dektronics/printalyzer-uvdensitometer/hardware/main-board/main-board.kicad_pcb

## KiCad design hardware/main-board/main-board.kicad_pcb (2025-02-21)

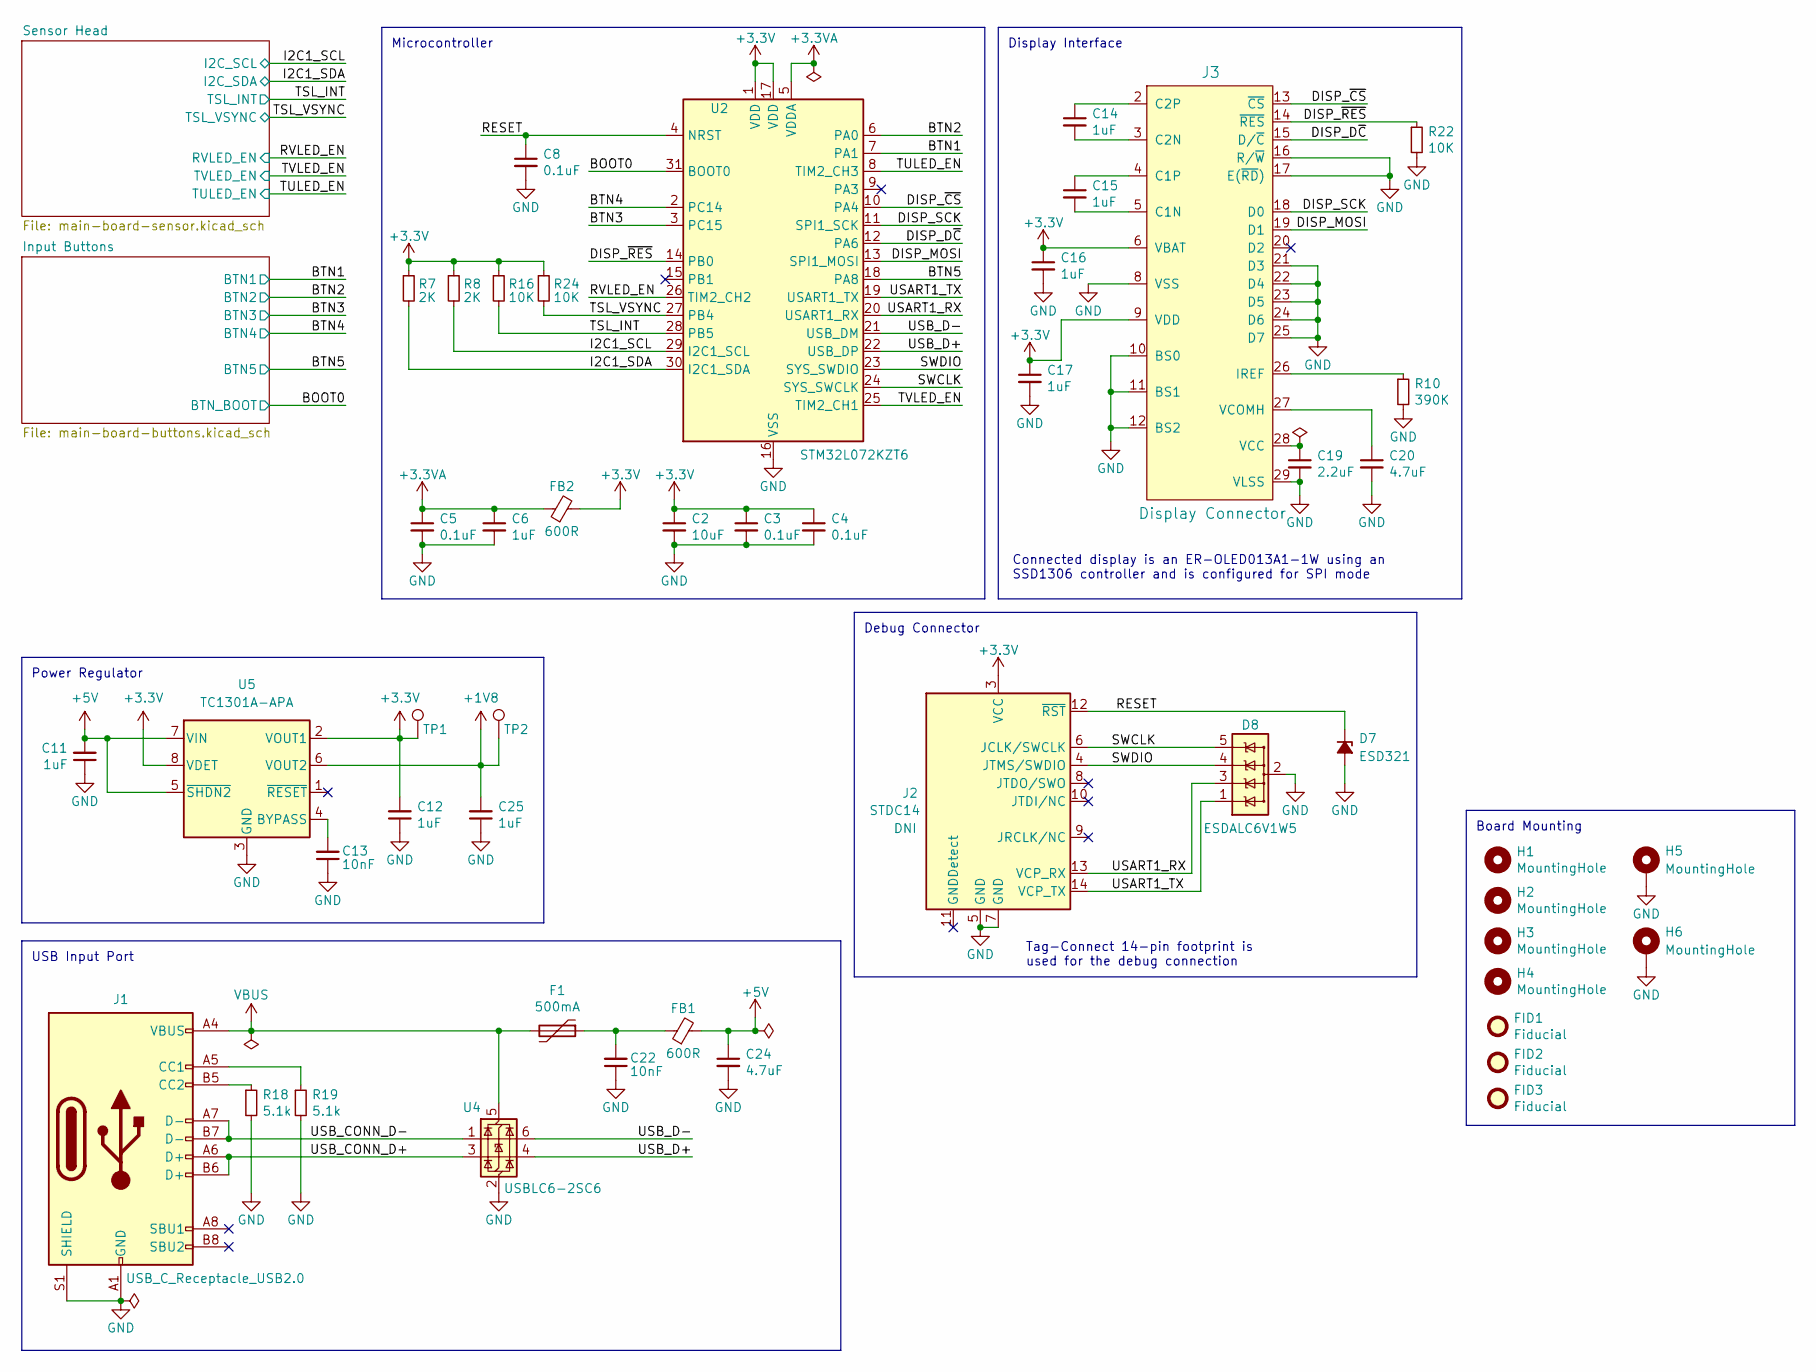
[picture p3: schematic main-board.kicad_sch, Printalyzer UV/VIS Densitometer - Main Board]

Parts:
C2: 10uF; C_0805_2012Metric; Manufacturer PN CL21A106KAYNNNE
C3, C4, C5, C8: 0.1uF; C_0603_1608Metric; Manufacturer PN CL10B104KA8NNNC
C6, C11, C12, C14, C15, C16, C17, C25: 1uF; C_0603_1608Metric; Manufacturer PN CL10B105KA8NNNC
C13, C22: 10nF; C_0603_1608Metric; Manufacturer PN CC0603KRX7R8BB103
C19: 2.2uF; C_0603_1608Metric; Manufacturer PN CL10B225KP8NNNC
C20, C24: 4.7uF; C_0603_1608Metric; Manufacturer PN CL10A475KA8NQNC
D7: ESD321; D_TI_SOD-523_DYA0002A; Manufacturer PN ESD321DYAR
D8: ESDALC6V1W5; SOT323-5L; Manufacturer PN ESDALC6V1W5
F1: 500mA; BF_0ZCJ_1206; Manufacturer PN 1206L050YR
FB1, FB2: 600R; L_0603_1608Metric; Manufacturer PN 742792651
FID1, FID2, FID3: Fiducial; Fiducial_1mm_Mask2mm
H1, H2, H3, H4: MountingHole; MountingHole_2.2mm_M2
H5, H6: MountingHole; MountingHole_2.2mm_M2_Pad_Via
J1: USB_C_Receptacle_USB2.0; USB_C_Receptacle_GCT_USB4105; Manufacturer PN USB4105-GF-A
J2: DNI; Tag-Connect_TC2070-IDC-FP_2x07_P1.27mm_Vertical; Manufacturer PN TC2070-IDC-050
J3: Display Connector; ER-CON30HT-1; Manufacturer PN ER-CON30HT-1
R7, R8: 2K; R_0603_1608Metric; Manufacturer PN CRCW06032K00JNEA
R10: 390K; R_0603_1608Metric; Manufacturer PN RC0603FR-07390KL
R16, R22, R24: 10K; R_0603_1608Metric; Manufacturer PN RC0603JR-0710KL
R18, R19: 5.1k; R_0603_1608Metric; Manufacturer PN RC0603JR-075K1L
TP1: 3.3V; TestPoint_Pad_D1.0mm
TP2: 1.8V; TestPoint_Pad_D1.0mm
U2: STM32L072KZT6; ST_LQFP32; Manufacturer PN STM32L072KZT6
U4: USBLC6-2SC6; SOT-23-6; Manufacturer PN USBLC6-2SC6
U5: TC1301A-APA; MSOP-8_3x3mm_P0.65mm; Manufacturer PN TC1301A-APAVUATR

Connections:
+1V8: C25.2, TP2.1, U5.6 (VOUT2); also elsewhere on the board
+3.3V: C2.1, C3.1, C4.1, C12.2, C16.1, C17.1, FB2.2, J2.3 (VCC), J3.6 (VBAT), J3.9 (VDD), R7.1, R8.1, R16.1, R24.1, TP1.1, U2.1 (VDD), U2.17 (VDD), U5.2 (VOUT1), U5.8 (VDET); also elsewhere on the board
+3.3VA: C5.1, C6.1, FB2.1, U2.5 (VDDA)
+5V: C11.2, C24.1, FB1.2, U5.5 (~SHDN2), U5.7 (VIN); also elsewhere on the board
/BOOT0: U2.31 (BOOT0); also elsewhere on the board
/BTN1: U2.7 (PA1); also elsewhere on the board
/BTN2: U2.6 (PA0); also elsewhere on the board
/BTN3: U2.3 (PC15); also elsewhere on the board
/BTN4: U2.2 (PC14); also elsewhere on the board
/BTN5: U2.18 (PA8); also elsewhere on the board
/DISP_D~C: J3.15 (D/~C), U2.12 (PA6)
/DISP_MOSI: J3.19 (D1), U2.13 (SPI1_MOSI)
/DISP_SCK: J3.18 (D0), U2.11 (SPI1_SCK)
/DISP_~CS: J3.13 (~CS), U2.10 (PA4)
/DISP_~RES: J3.14 (~RES), R22.1, U2.14 (PB0)
/I2C1_SCL: R8.2, U2.29 (I2C1_SCL); also elsewhere on the board
/I2C1_SDA: R7.2, U2.30 (I2C1_SDA); also elsewhere on the board
/RESET: C8.1, D7.2 (K), J2.12 (~RST), U2.4 (NRST)
/RVLED_EN: U2.26 (TIM2_CH2); also elsewhere on the board
/SWCLK: D8.5 (IO4), J2.6 (JCLK/SWCLK), U2.24 (SYS_SWCLK)
/SWDIO: D8.4 (IO3), J2.4 (JTMS/SWDIO), U2.23 (SYS_SWDIO)
/TSL_INT: R16.2, U2.28 (PB5); also elsewhere on the board
/TSL_VSYNC: R24.2, U2.27 (PB4); also elsewhere on the board
/TULED_EN: U2.8 (TIM2_CH3); also elsewhere on the board
/TVLED_EN: U2.25 (TIM2_CH1); also elsewhere on the board
/USART1_RX: D8.3 (IO2), J2.13 (VCP_RX), U2.20 (USART1_RX)
/USART1_TX: D8.1 (IO1), J2.14 (VCP_TX), U2.19 (USART1_TX)
/USB_CONN_D+: J1.A6 (D+), J1.B6 (D+), U4.3 (I/O2)
/USB_CONN_D-: J1.A7 (D-), J1.B7 (D-), U4.1 (I/O1)
/USB_D+: U2.22 (USB_DP), U4.4 (I/O2)
/USB_D-: U2.21 (USB_DM), U4.6 (I/O1)
GND: C2.2, C3.2, C4.2, C5.2, C6.2, C8.2, C11.1, C12.1, C13.1, C16.2, C17.2, C19.2, C20.2, C22.1, C24.2, C25.1, D7.1 (A), D8.2 (GND), H5.1, H6.1, J1.A1 (GND), J1.A12 (GND), J1.B1 (GND), J1.B12 (GND), J1.S1 (SHIELD), J2.5 (GND), J2.7 (GND), J3.8 (VSS), J3.10 (BS0), J3.11 (BS1), J3.12 (BS2), J3.16 (R/~W), J3.17 (E(~RD)), J3.21 (D3), J3.22 (D4), J3.23 (D5), J3.24 (D6), J3.25 (D7), J3.29 (VLSS), R10.2, R18.2, R19.2, R22.2, U2.16 (VSS), U2.32 (VSS), U4.2 (GND), U5.3 (GND); also elsewhere on the board
unnamed: C22.2, F1.1, FB1.1
unnamed: J1.A5 (CC1), R19.1
unnamed: J1.B5 (CC2), R18.1
unnamed: C15.2, J3.5 (C1N)
unnamed: C15.1, J3.4 (C1P)
unnamed: C14.2, J3.3 (C2N)
unnamed: C14.1, J3.2 (C2P)
unnamed: J3.26 (IREF), R10.1
unnamed: C19.1, J3.28 (VCC)
unnamed: C20.1, J3.27 (VCOMH)
unnamed: C13.2, U5.4 (BYPASS)
VBUS: F1.2, J1.A4 (VBUS), J1.A9 (VBUS), J1.B4 (VBUS), J1.B9 (VBUS), U4.5 (VBUS)

Notes on the sheet:
Board Mounting
Tag-Connect 14-pin footprint is used for the debug connection
Power Regulator
Display Interface
Debug Connector
USB Input Port
Connected display is an ER-OLED013A1-1W using an SSD1306 controller and is configured for SPI mode
Microcontroller

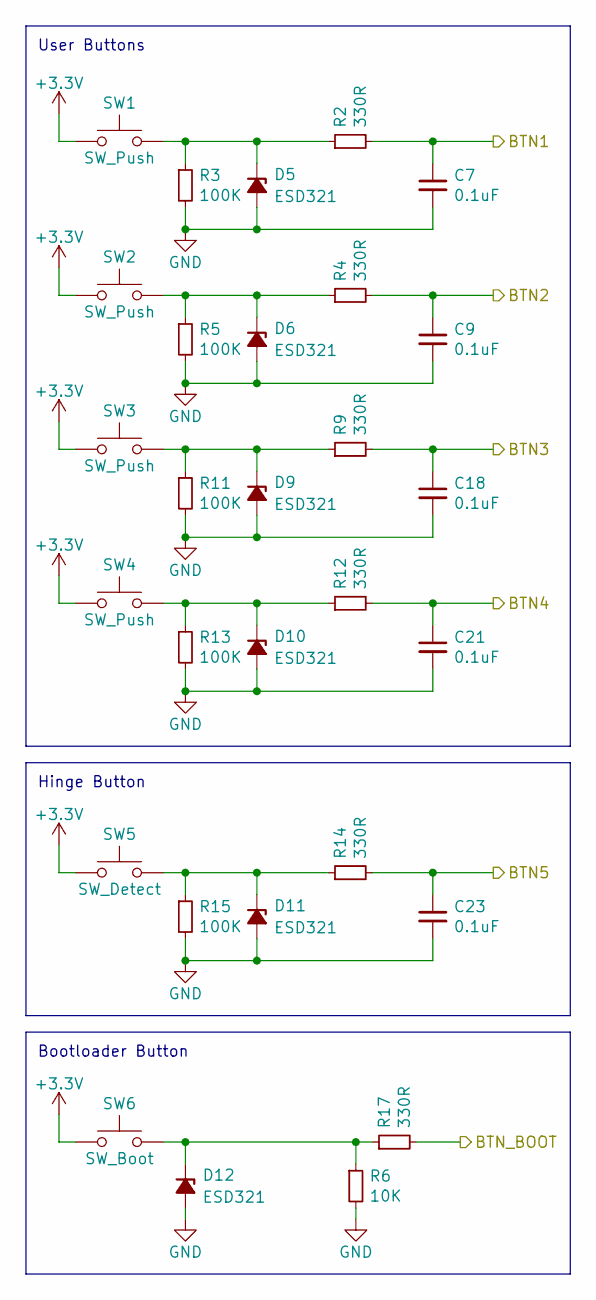
[picture p4: schematic main-board-buttons.kicad_sch, Printalyzer UV/VIS Densitometer - Main Board]

Parts:
C7, C9, C18, C21, C23: 0.1uF; C_0603_1608Metric; Manufacturer PN CL10B104KA8NNNC
D5, D6, D9, D10, D11, D12: ESD321; D_TI_SOD-523_DYA0002A; Manufacturer PN ESD321DYAR
R2, R4, R9, R12, R14, R17: 330R; R_0603_1608Metric; Manufacturer PN RC0603JR-07330RL
R3, R5, R11, R13, R15: 100K; R_0603_1608Metric; Manufacturer PN RC0603JR-07100KL
R6: 10K; R_0603_1608Metric; Manufacturer PN RC0603JR-0710KL
SW1, SW2, SW3, SW4: SW_Push; ESwitch_TL1105_6mm_H7.5mm; Manufacturer PN TL1105SPF160Q
SW5: SW_Detect; CK_KSU213WLFG; Manufacturer PN KSU213WLFG
SW6: SW_Boot; Panasonic_EVQP7C_EVQP7L; Manufacturer PN EVQ-P7L01P

Connections:
+3.3V: SW1.1, SW2.1, SW3.1, SW4.1, SW5.1, SW6.1; also elsewhere on the board
/BOOT0: R17.2; also elsewhere on the board
/BTN1: C7.1, R2.2; also elsewhere on the board
/BTN2: C9.1, R4.2; also elsewhere on the board
/BTN3: C18.1, R9.2; also elsewhere on the board
/BTN4: C21.1, R12.2; also elsewhere on the board
/BTN5: C23.1, R14.2; also elsewhere on the board
GND: C7.2, C9.2, C18.2, C21.2, C23.2, D5.1 (A), D6.1 (A), D9.1 (A), D10.1 (A), D11.1 (A), D12.1 (A), R3.2, R5.2, R6.2, R11.2, R13.2, R15.2; also elsewhere on the board
unnamed: D5.2 (K), R2.1, R3.1, SW1.2
unnamed: D6.2 (K), R4.1, R5.1, SW2.2
unnamed: D9.2 (K), R9.1, R11.1, SW3.2
unnamed: D10.2 (K), R12.1, R13.1, SW4.2
unnamed: D11.2 (K), R14.1, R15.1, SW5.2
unnamed: D12.2 (K), R6.1, R17.1, SW6.2

Notes on the sheet:
User Buttons
Hinge Button
Bootloader Button

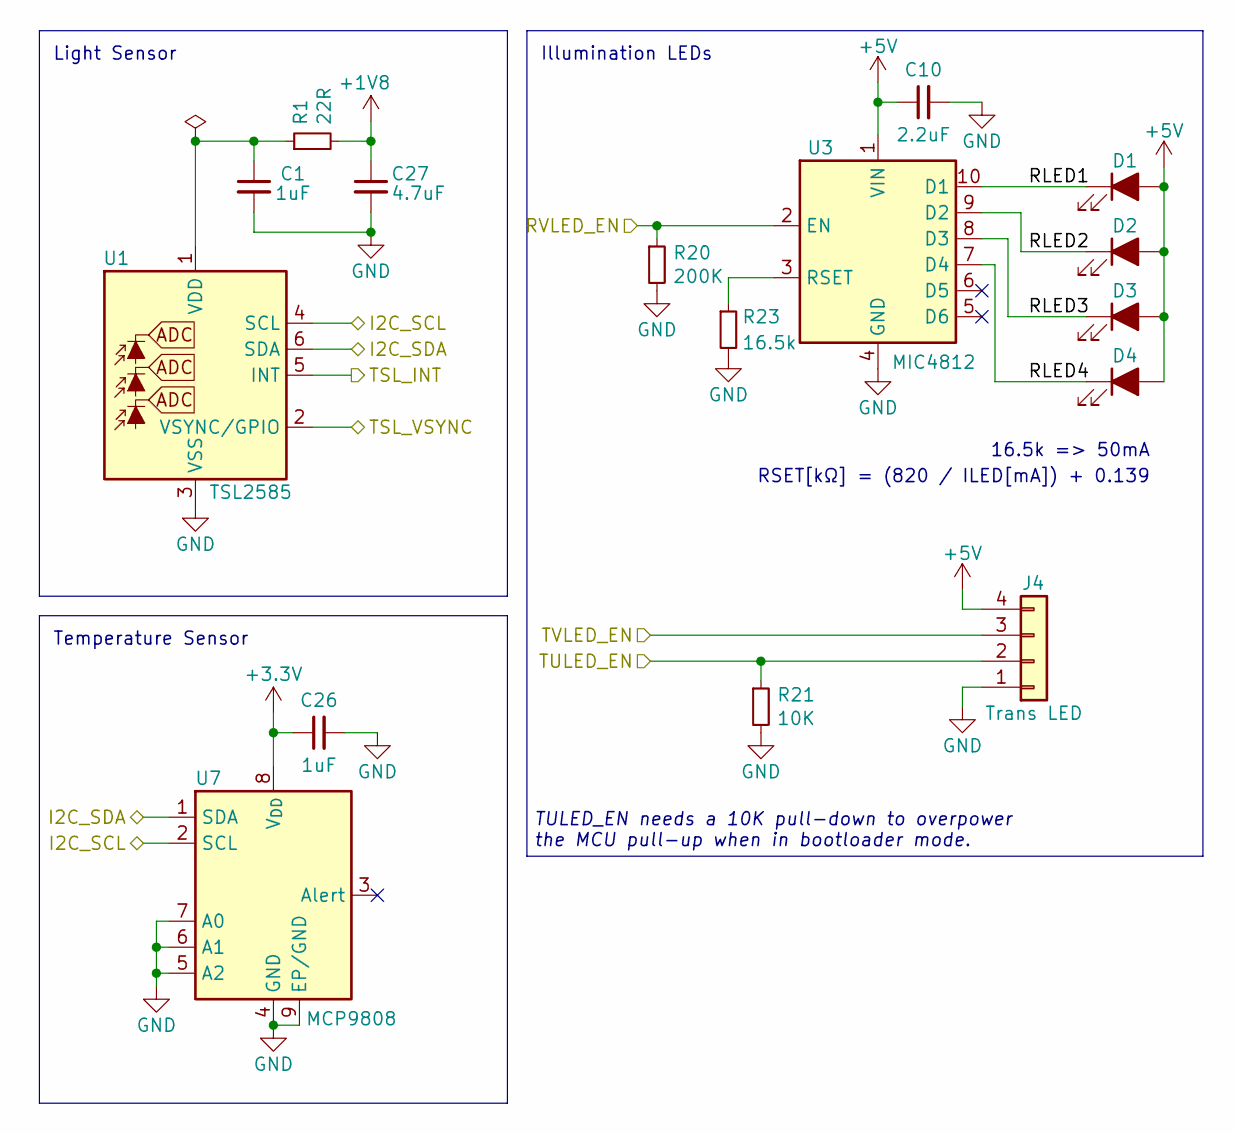
[picture p5: schematic main-board-sensor.kicad_sch, Printalyzer UV/VIS Densitometer - Main Board]

Parts:
C1, C26: 1uF; C_0402_1005Metric; Manufacturer PN CL05A105KQ5NNNC
C10: 2.2uF; C_0603_1608Metric; Manufacturer PN CL10B225KP8NNNC
C27: 4.7uF; C_0402_1005Metric; Manufacturer PN CL05A475KQ5NRNC
D1, D2, D3, D4: LED; SunLike_LED_S1S0; Manufacturer PN S1S0-3030309503-0000003S-0P001
J4: Conn_01x04; JST_SH_BM04B-SRSS-TB_1x04-1MP_P1.00mm_Vertical; Manufacturer PN BM04B-SRSS-TB(LF)(SN)
R1: 22R; R_0402_1005Metric; Manufacturer PN AC0402JR-0722RL
R20: 200K; R_0603_1608Metric; Manufacturer PN CPF0603F200KC1
R21: 10K; R_0603_1608Metric; Manufacturer PN RC0603JR-0710KL
R23: 16.5k; R_0603_1608Metric; Manufacturer PN CPF0603F16K5C1
U1: TSL2585; AMS_TSL2585_OLGA-6_2x1mm_P0.65mm; Manufacturer PN TSL25853PM
U3: MIC4812; Micrel_MSOP-10-1EP_3x3mm_P0.5mm_EP1.73x1.7mm_ThermalVias; Manufacturer PN MIC4812YMME
U7: MCP9808; DFN-8-1EP_3x2mm_P0.5mm_EP1.7x1.4mm; Manufacturer PN MCP9808T-E/MC

Connections:
+1V8: C27.1, R1.2; also elsewhere on the board
+3.3V: C26.1, U7.8 (V_{DD}); also elsewhere on the board
+5V: C10.1, D1.2 (A), D2.2 (A), D3.2 (A), D4.2 (A), J4.4, U3.1 (VIN); also elsewhere on the board
/I2C1_SCL: U1.4 (SCL), U7.2 (SCL); also elsewhere on the board
/I2C1_SDA: U1.6 (SDA), U7.1 (SDA); also elsewhere on the board
/RVLED_EN: R20.1, U3.2 (EN); also elsewhere on the board
/Sensor Head/RLED1: D1.1 (K), U3.10 (D1)
/Sensor Head/RLED2: D2.1 (K), U3.9 (D2)
/Sensor Head/RLED3: D3.1 (K), U3.8 (D3)
/Sensor Head/RLED4: D4.1 (K), U3.7 (D4)
/TSL_INT: U1.5 (INT); also elsewhere on the board
/TSL_VSYNC: U1.2 (VSYNC/GPIO); also elsewhere on the board
/TULED_EN: J4.2, R21.1; also elsewhere on the board
/TVLED_EN: J4.3; also elsewhere on the board
GND: C1.2, C10.2, C26.2, C27.2, J4.1, R20.2, R21.2, R23.2, U1.3 (VSS), U3.4 (GND), U3.11 (EP), U7.4 (GND), U7.5 (A2), U7.6 (A1), U7.7 (A0), U7.9 (EP/GND); also elsewhere on the board
unnamed: C1.1, R1.1, U1.1 (VDD)
unnamed: R23.1, U3.3 (RSET)

Notes on the sheet:
Light Sensor
16.5k => 50mA
Illumination LEDs
Temperature Sensor
RSET[kΩ] = (820 / ILED[mA]) + 0.139
TULED_EN needs a 10K pull-down to overpower the MCU pull-up when in bootloader mode.

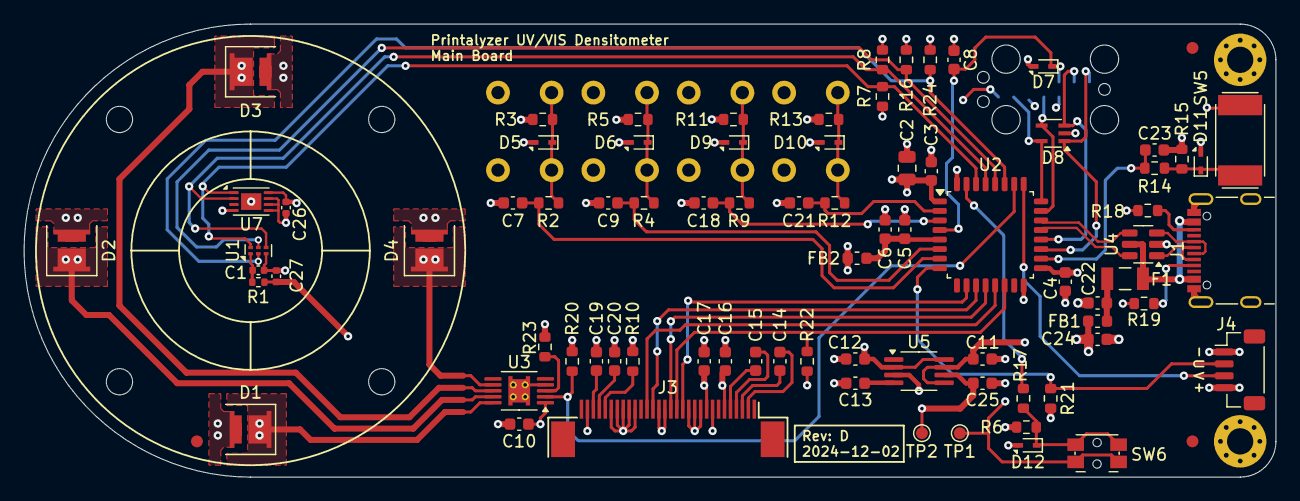
[picture p6: board main-board.kicad_pcb from above]

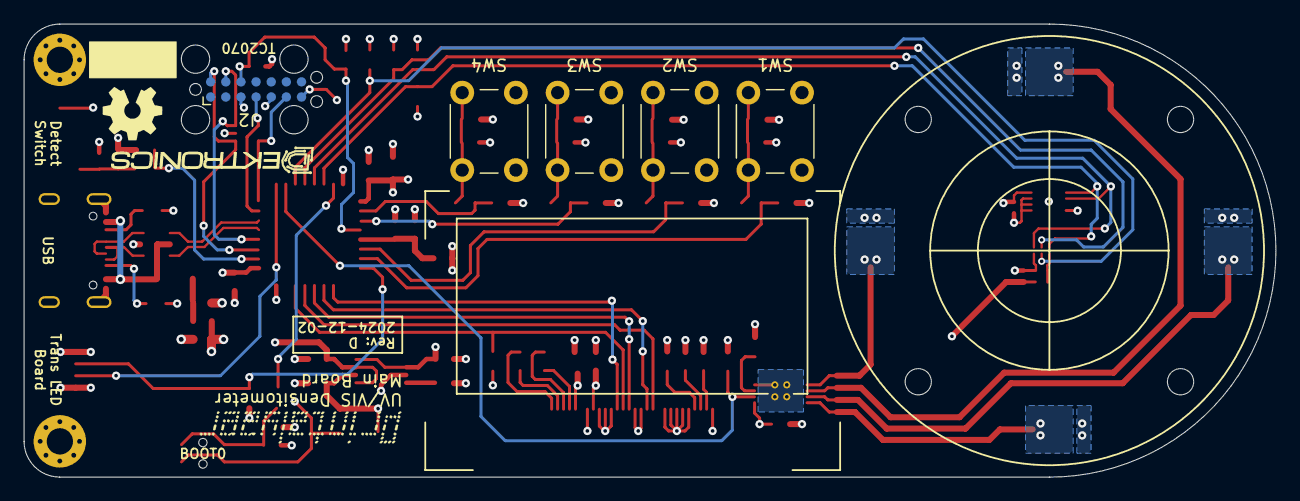
[picture p7: board main-board.kicad_pcb from below]

Board: 4 copper layers, 105.0 x 38.0 mm, 101 parts (8 on the bottom side), 56 nets.

Other parts of the board:
G1: LOGO; Printalyzer-logo-16_9mm
G4: OSHW-logo_5mm
LOGO: G3; Dektronics-logo
REF1, REF2, REF4, REF5, REF6: Tab
