dektronics/printalyzer-uvdensitometer/hardware/trans-led-al-board/trans-led-al-board.kicad_pcb

## KiCad design hardware/trans-led-al-board/trans-led-al-board.kicad_pcb (2023-10-08)

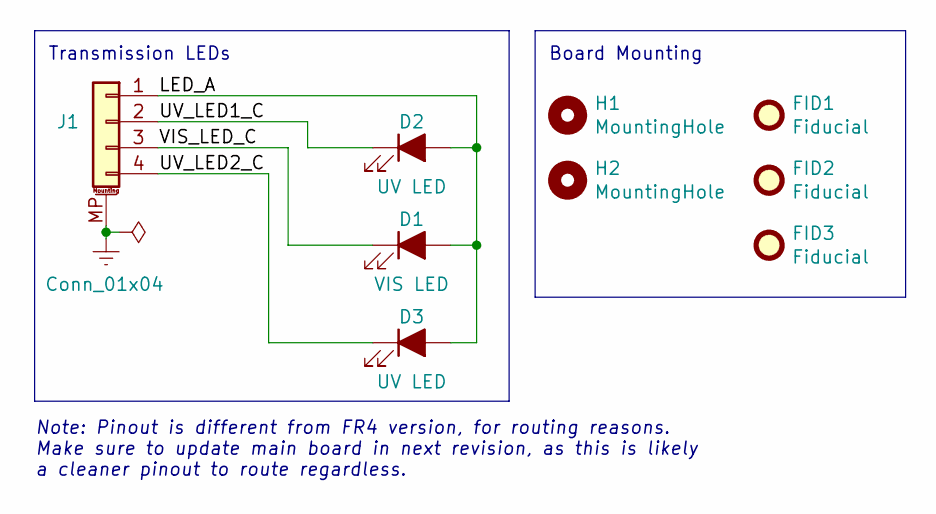
[picture p8: schematic trans-led-al-board.kicad_sch, Printalyzer UV/VIS Densitometer - Transmission LED Al Board]

Parts:
D1: VIS LED; SunLike_LED_S1S0_Narrow; Manufacturer PN S1S0-3030309503-0000003S-0P001
D2, D3: UV LED; LED_WL-SUTW-2835_Narrow; Manufacturer PN 153283387A212
FID1, FID2, FID3: Fiducial; Fiducial_1mm_Mask2mm
H1, H2: MountingHole; MountingHole_2.2mm_M2
J1: Conn_01x04; JST_SH_SM04B-SRSS-TB_1x04-1MP_P1.00mm_Horizontal; Manufacturer PN SM04B-SRSS-TB

Connections:
/LED_A: D1.2 (A), D2.2 (A), D3.2 (A), J1.1
/UV_LED1_C: D2.1 (K), J1.2
/UV_LED2_C: D3.1 (K), J1.4
/VIS_LED_C: D1.1 (K), J1.3
Earth: J1.MP (MountPin)

Notes on the sheet:
Board Mounting
Transmission LEDs
Note: Pinout is different from FR4 version, for routing reasons. Make sure to update main board in next revision, as this is likely a cleaner pinout to route regardless.

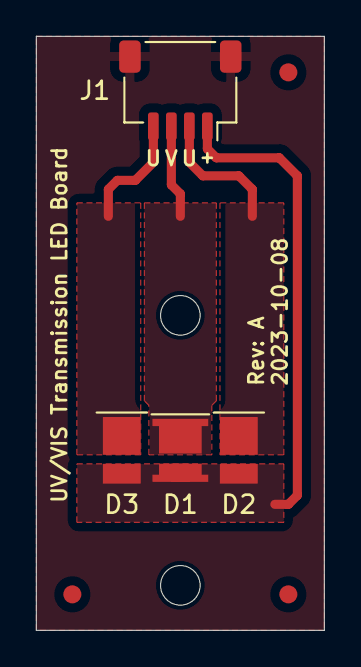
[picture p9: board trans-led-al-board.kicad_pcb from above]

Board: 2 copper layers, 16.0 x 33.0 mm, 9 parts (0 on the bottom side), 4 nets.
